CaptainRexX7/EmbeddedSystems/BalanceRobot/motorRobot.step

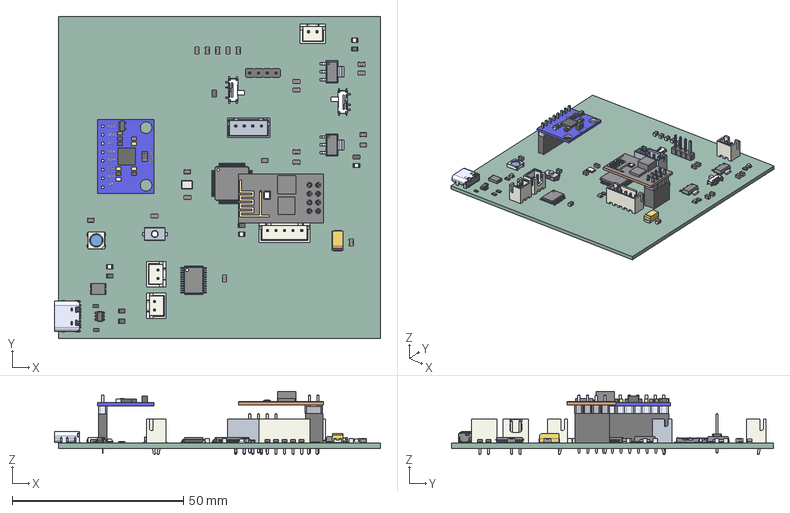
[picture p4: CAD file, 2026-06-09]
BalanceRobot/motorRobot.step
95.1 x 94.0 x 18.4 mm
JST_XH_B5B-XH-A_1x05_P2.50mm_Vertical
LED_0805_2012Metric x 4
C_0805_2012Metric x 21
PinSocket_2x04_P2.54mm_Vertical
ESP8266-01_ESP-01
PinSocket_1x08_P2.54mm_Vertical
8 Header-Pin
Placa_Base
LD1117S50TR x 2
Crystal_SMD_Abracon_ABM8G-4Pin_3.2x2.5mm
JST_XH_B2B-XH-A_1x02_P2.50mm_Vertical x 3
SLW-66527511-SMT-TR x 2
R_0805_2012Metric x 8
PinHeader_1x04_P2.54mm_Vertical
CP_EIA-6032-28_Kemet-C
base
top cover
pins x 2
STM32F401RBT6
USB4105xxx_USB4105GFA060
TB6612FNG,C,8,EL
MF-MSMF050-2--3DModel-STEP-56544
R_0603_1608Metric x 2
motorRobot 1.47
LED_WS2812B_PLCC4_5.0x5.0mm_P3.2mm
SOT-23-6
Kicad1_PCB
