CaptainRexX7/EmbeddedSystems/Onshape/Part Studio 1 - Part 1.dxf

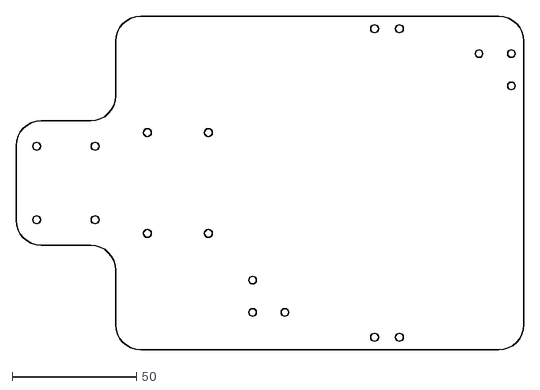
[picture p5: CAD file, 2026-06-09]
Onshape/Part Studio 1 - Part 1.dxf
204.0 x 134.0
