CaptainRexX7/EmbeddedSystems/Onshape/Clamps.stl

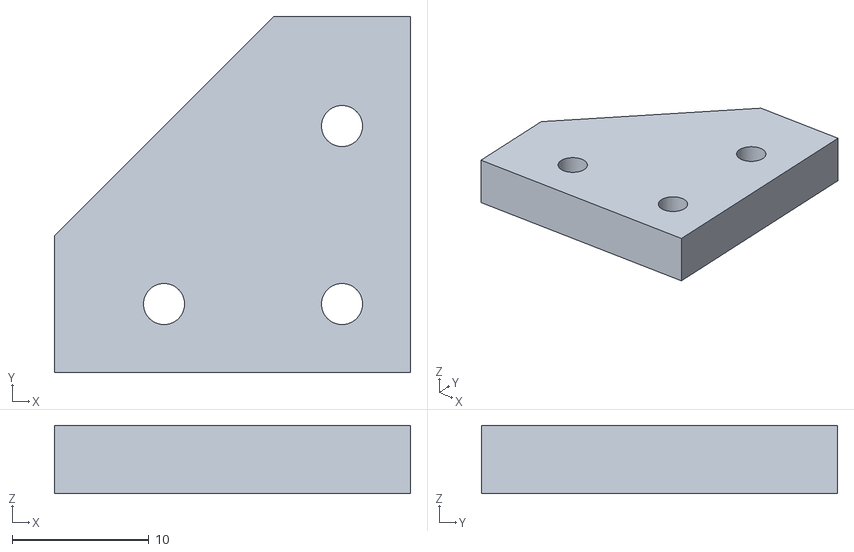
[picture p6: CAD file, 2026-06-09]
Onshape/Clamps.stl
26.0 x 26.0 x 5.00
